gnawnah/approx-mult/docs/figures/utilisation_exact.png

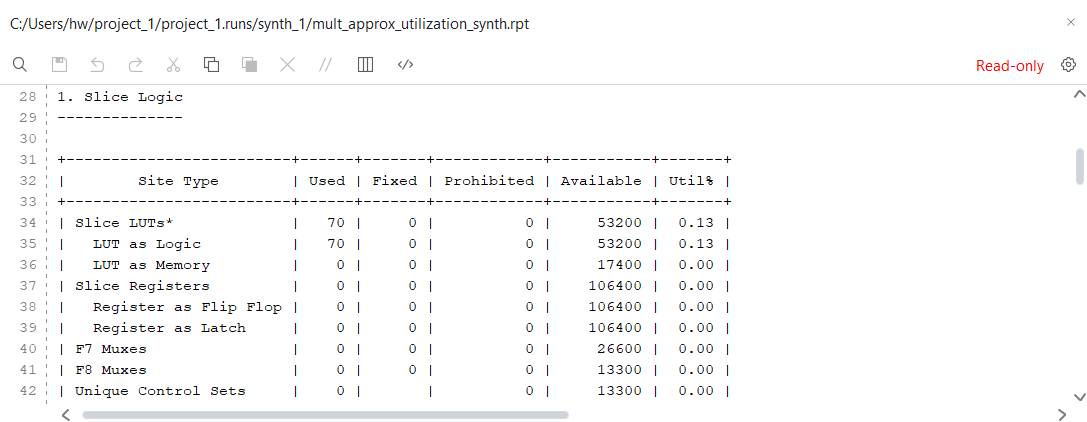
docs/figures/utilisation_exact.png
