gnawnah/approx-mult/results/energy_results.csv

trunc_bits | luts | accuracy_pct | dynamic_power_W | clk_mhz | energy_per_mac_pJ | latency_per_inference_ms | energy_per_inference_uJ | edp_uJ_ms
0 | 64 | 97.73 | 0.001183594 | 100.0 | 11.8 | 1.016 | 1.2 | 1.223
2 | 42 | 97.67 | 0.000808594 | 100.0 | 8.1 | 1.016 | 0.82 | 0.835
4 | 15 | 81.4 | 0.000351562 | 100.0 | 3.5 | 1.016 | 0.36 | 0.363
6 | 4 | 9.74 | 0.000214844 | 100.0 | 2.1 | 1.016 | 0.22 | 0.222
