gnawnah/approx-mult/results/mnist_quantized_results.csv

trunc_bits | accuracy
0 | 0.9773
1 | 0.9776
2 | 0.9767
3 | 0.9704
4 | 0.814
5 | 0.1064
6 | 0.0974
7 | 0.0974
