gnawnah/approx-mult/constr/uart_rx_constraints.xdc

set_property -dict {PACKAGE_PIN Y9  IOSTANDARD LVCMOS33} [get_ports clk]
create_clock -period 20.000 -name sys_clk [get_ports clk]
set_property -dict {PACKAGE_PIN N15 IOSTANDARD LVCMOS33} [get_ports rx]

set_property -dict {PACKAGE_PIN N22 IOSTANDARD LVCMOS33} [get_ports {led[0]}]
set_property -dict {PACKAGE_PIN P22 IOSTANDARD LVCMOS33} [get_ports {led[1]}]
set_property -dict {PACKAGE_PIN R18 IOSTANDARD LVCMOS33} [get_ports {led[2]}]
set_property -dict {PACKAGE_PIN T18 IOSTANDARD LVCMOS33} [get_ports {led[3]}]
set_property -dict {PACKAGE_PIN P20 IOSTANDARD LVCMOS33} [get_ports {led[4]}]
set_property -dict {PACKAGE_PIN P21 IOSTANDARD LVCMOS33} [get_ports {led[5]}]
set_property -dict {PACKAGE_PIN R20 IOSTANDARD LVCMOS33} [get_ports {led[6]}]
set_property -dict {PACKAGE_PIN R21 IOSTANDARD LVCMOS33} [get_ports {led[7]}]
