gnawnah/approx-mult/rtl/weight_mem.v

// ROM (read-only weight memory)

module weight_mem #(
    parameter WIDTH = 8,
    parameter DEPTH = 256,
    parameter ADDR = 8 // number of bits to address DEPTH words
)(
    input wire clk,
    input wire [ADDR-1:0] addr0, // port A address
    input wire [ADDR-1:0] addr1, // port B address
    output reg [WIDTH-1:0] data_out0, // port A data
    output reg [WIDTH-1:0] data_out1  // port B data
);

    reg [WIDTH-1:0] mem [0:DEPTH-1]; // a 1d array that has DEPTH terms, each term is WIDTH bits

    initial begin
        //`define WEIGHTS_FILE "C:/Users/hw/bram_report/bram_report.srcs/sources_1/imports/Downloads/weights.hex"
        //$readmemh(`WEIGHTS_FILE, mem);
        $readmemh("weights.hex", mem);
    end

    always @(posedge clk) begin
        // two simultaneous reads
        data_out0 <= mem[addr0]; // reading mem[addr] only happens on clock tick
        data_out1 <= mem[addr1];
    end
endmodule
