gnawnah/approx-mult/(commit log)

2026-06-28 approximate multiplier (input truncation) + error-measuring testbench; T=0 exact, T=2 characterized
    [mult_approx.v, tb_mult_approx.v]
2026-06-28 truncate both operands, T=2 max error 1521
    [mult_approx.v, tb_mult_approx.v]
2026-06-28 sweep T=0..8, error data + csv
    [sweep_results.csv]
2026-06-28 approximate MAC, error accumulates over dot product
    [mac.v, tb_mac.v]
2026-06-30 complete MAC sweep: luts, ffs, dynamic power across truncation
    [mac_results.csv]
2026-06-30 2D grid sweep over width and truncation
    [grid_results.csv]
2026-06-30 2D cost grid: luts vs width and truncation, precision dominates truncation
    [grid_cost.csv]
2026-06-30 Add MNIST approximate inference experiment
    [mnist_quantized_results.csv]
2026-06-30 expand readme: power, bit-width, MNIST, full results
2026-07-01 add de-bias correction term, ~40% error reduction at T=2
    [mult_approx.v, tb_mult_approx.v]
2026-07-01 de-bias correction in MAC: matched constant cancels accumulated bias (3021 to 1)
    [mac.v, tb_mac.v]
2026-07-01 de-bias correction on MNIST: helps at cliff edge (+0.84% at T=4), cannot move cliff (variance-driven)
    [mnist_corrected_results.csv]
2026-07-01 add de-bias plot, precise AI-authorship note, tidy files
2026-07-02 add UART TX code
2026-07-02 add UART RX code
2026-07-02 Working UART echo loop on Zynq (RX to TX, one state machine)
2026-07-02 deploy approximate multiplier on Zynq, two 8-bit operands over UART, 16-bit result returned
2026-07-20 fix reproducibility: relative readmemh path, DEPTH/hex size match, restore zero slot
    [tb_mem_systolic.v, weight_mem.v]
2026-07-20 fix sweep: CORRECTION was defaulting to 380, contaminating all DSE results
    [tb_mult_approx.v]
2026-07-20 fix tb_mac reference model, derive Pareto plot from CSVs, clean sweep data
    [tb_mac.v]
2026-07-22 pin requirements versions, add run script and gitignore
2026-08-01 add energy metric (pJ/MAC, uJ/inference, EDP), rewrite README, exclude Python from language stats
    [energy_results.csv]
2026-08-01 restructure into rtl/tb/syn/constr/flow tree, add scripted MAC synthesis and report parser
    [grid_cost.csv, grid_results.csv, mac_results.csv, mnist_corrected_results.csv, mnist_quantized_results.csv, sweep_results.csv]
2026-08-16 add mac_array harness, measure energy out of context, commit vivado reports
    [energy_results.csv, mac_results.csv]
2026-08-21 driver done
2026-08-22 fix mac_driver starting mac_monitor
    [mac_driver.sv, mac_monitor.sv]
